alexmuraru27/GameConsole/docu/clock.png

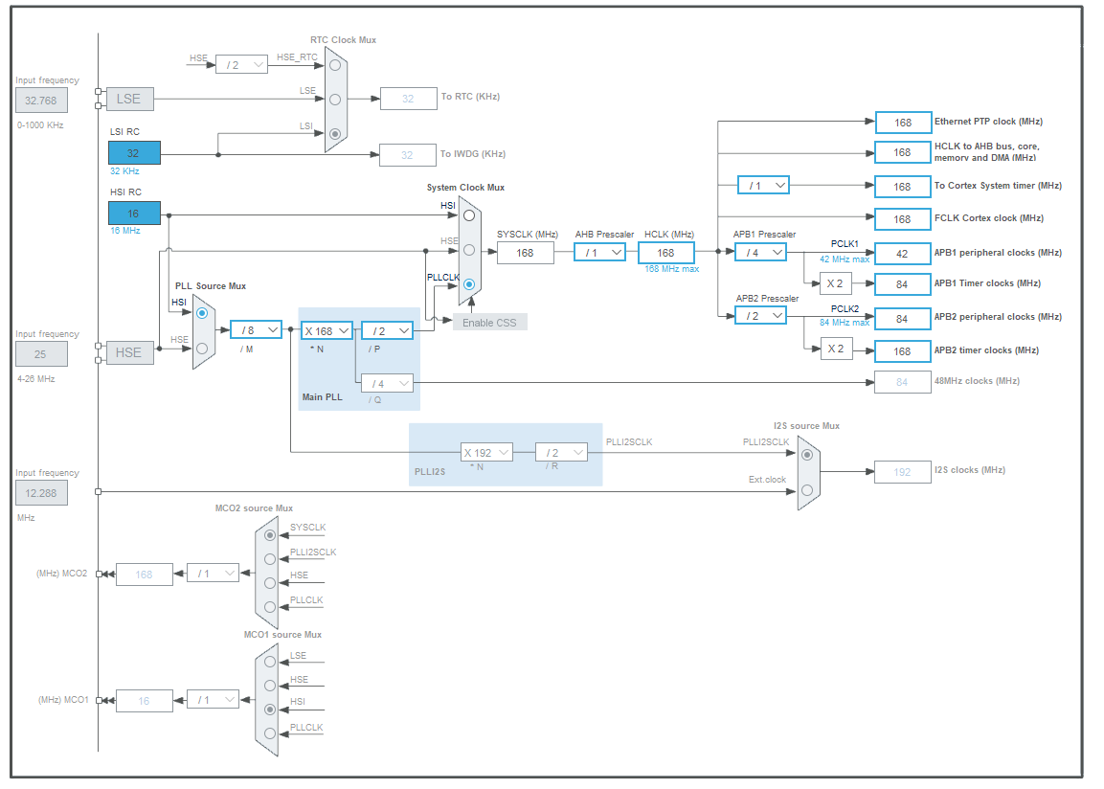
docu/clock.png
