alexmuraru27/GameConsole/docu/tile_creator_docu.png

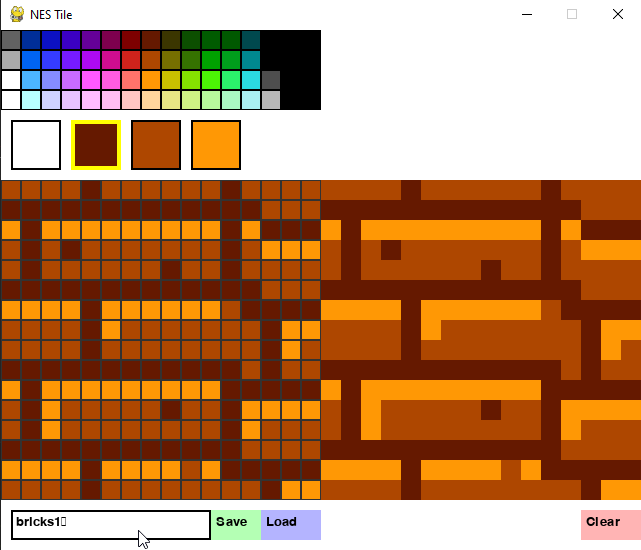
docu/tile_creator_docu.png
