alexmuraru27/GameConsole/docu/HW/BOM_Initial Layout_PCB1_2026-05-29.xlsx

No. | Quantity | Comment | Designator | Footprint | Value | Manufacturer Part | Manufacturer | Supplier Part | Supplier | Primary Category | Secondary Category | Pin Count | LCSC Stock | LCSC Price | JLCPCB Stock | JLCPCB Price | Layer | Mounting Style | Convert to PCB | Add into BOM | 3D Model Title | Device | Name | Unique ID
1 | 2 | YK16S-L7.2-B10Ka(32-8)-G-A29 | AnalogJoyL,AnalogJoyR | JOYTICK-TH_YF16S-FL7.2-B5KB-45-10-Y_1 |  | YK16S-L7.2-B10Ka(32-8)-G-A29 | YTL(亚特联) | C37323746 | LCSC | Switches | Navigation Switches, Joystick | 14 |  |  | 827 | 0.0674 | T | DIP |  | yes | JOYTICK-TH_YF16S-FL7.2-B5KB-45-10-Y_1 | YK16S-L7.2-B10Ka(32-8)-G-A29 | YK16S-L7.2-B10Ka(32-8)-G-A29 | gge6,gge30
2 | 1 | X6511WR-02H-C60D30R2 | BATCON | HDR-TH_2P-P2.54-H-M-W9.7-N |  | X6511WR-02H-C60D30R2 | XKB Connection(中国星坤) | C2883679 | LCSC | Connectors | Pin Headers | 2 |  |  | 74 | 0.0071 | T | DIP |  | yes | HDR-TH_2P-P2.54-H-M-W9.7-N | X6511WR-02H-C60D30R2 | X6511WR-02H-C60D30R2 | gge84
3 | 1 | 2.7kHz | BUZZER1 | BUZ-SMD_4P-L8.5-W8.5-P8.50-BR | 2.7kHz | MLT-8530 | 华能 | C94599 | LCSC | Audio Products / Vibration Motors | Buzzers | 4 |  |  | 86386 | 0.0306 | T | SMT |  | yes | BUZ-SMD_4P-L8.5-W8.5-H3.0 | MLT-8530 | 2.7kHz | gge69
4 | 1 | PM254-2-04-S-8.5 | CN1 | HDR-SMD_8P-P2.54-V-F-R2-C4-S7.1 |  | PM254-2-04-S-8.5 | HCTL(华灿天禄) | C3975149 | LCSC | Connectors | Female Headers | 8 |  |  | 10441 | 0.0268 | T | SMT |  | yes | HDR-SMD_8P-P2.54-V-F-R2-C4-S7.1 | PM254-2-04-S-8.5 | PM254-2-04-S-8.5 | gge73
5 | 1 | X9555WR-2x10-6TV01 | CN2 | CONN-TH_20P-P2.54_XKB_X9555WR-2X10-6TV01 |  | X9555WR-2x10-6TV01 | XKB Connection(中国星坤) | C2884508 | LCSC | Connectors | Wire To Board Connector | 20 |  |  | 1843 | 0.0416 | T | DIP |  | yes | CONN-TH_20P-P2.54_XKB_X9555WR-2X10-6TV01 | X9555WR-2x10-6TV01 | X9555WR-2x10-6TV01 | gge85
6 | 3 | 100nF | C_BAT,C_JTAG,C_SD_VCC | C0402 | 100nF | CL05B104KB54PNC | SAMSUNG(三星) | C307331 | LCSC | Capacitors | Multilayer Ceramic Capacitors MLCC - SMD/SMT | 2 |  |  | 8421035 | 0.0008 | T | SMT |  | yes | C0402_L1.0-W0.5-H0.5 | CL05B104KB54PNC | 100nF | gge32,gge32_2,gge32_3
7 | 1 | 100nF | C_ESP | C0603 | 100nF | CC0603KRX7R9BB104 | YAGEO(国巨) | C14663 | LCSC | Capacitors | Multilayer Ceramic Capacitors MLCC - SMD/SMT | 2 |  |  | 31271923 | 0.0006 | T | SMT |  | yes | C0603_L1.6-W0.8-H0.8 | CC0603KRX7R9BB104 | 100nF | gge83
8 | 2 | 10uF | C_VCAP_1,C_VCAP_2 | C1206 | 10uF | CL31A106KBHNNNE | SAMSUNG(三星) | C13585 | LCSC | Capacitors | Multilayer Ceramic Capacitors MLCC - SMD/SMT | 2 |  |  | 2125757 | 0.0116 | T | SMT |  | yes | C1206_L3.2-W1.6-H1.3 | CL31A106KBHNNNE | 10uF | gge1,gge2
9 | 2 | 22pF | C_XTAL1,C_XTAL2 | C0805 | 22pF | CL21C220JBANNNC | SAMSUNG(三星) | C1804 | LCSC | Capacitors | Multilayer Ceramic Capacitors MLCC - SMD/SMT | 2 |  |  | 173636 | 0.0018 | T | SMT |  | yes | C0805_L2.0-W1.3-H1.3 | CL21C220JBANNNC | 22pF | gge13,gge14
10 | 1 | PZ254V-11-02P | Debug | HDR-TH_2P-P2.54-V-M |  | PZ254V-11-02P | XFCN(兴飞) | C492401 | LCSC | Connectors | Pin Headers | 2 |  |  | 1067702 | 0.0024 | T | DIP |  | yes | HDR2.54-M-LI-1X2P | PZ254V-11-02P | PZ254V-11-02P | gge86
11 | 1 | AT24C512C | EEPROM | SOIC-8_L4.9-W3.9-P1.27-LS6.0-BL |  | AT24C512C | MICROCHIP(美国微芯) | C12371 | LCSC | Memory | EEPROM | 8 |  |  | 39460 | 0.0819 | T | SMT |  | yes | SOIC-8_L4.9-W3.9-H1.7-LS6.0-P1.27 | AT24C512C-SSHD-T | AT24C512C | gge82
12 | 1 | FH-00357 | H2 | CONN-SMD_FH-00357 |  | FH-00357 | Liansheng(连盛) | C2685114 | LCSC | Connectors | Female Headers | 34 |  |  | 1083 | 0.0895 | T | SMT |  | yes | CONN-SMD_FH-00357 | FH-00357 | FH-00357 | gge79
13 | 1 | TF PUSH | MicroSD | TF-SMD_TF-PUSH |  | TF PUSH | SHOU HAN(首韩) | C393941 | LCSC | Connectors | SD Card / Memory Card Connector | 13 |  |  | 182236 | 0.0097 | T | SMT |  | yes | TF-SMD_TF-PUSH | TF PUSH | TF PUSH | gge5
14 | 1 | AO3400-SOT23-3L | Q_BUZZ | SOT-23-3_L2.9-W1.6-P1.90-LS2.8-BR |  | AO3400-SOT23-3L | PUOLOP(迪浦) | C332102 | LCSC | Transistors/Thyristors | MOSFETs | 3 |  |  | 12378 | 0.0047 | T | SMT |  | yes | SOT-23-3L_L2.9-W1.6-H1.1-LS2.8-P0.95 | AO3400-SOT23-3L | AO3400-SOT23-3L | gge80
15 | 17 | 10kΩ | R_BT0,R_BT1,R_BUZZ_PD,R_ESP_1,R_ESP_2,R_ESP_3,R_ESP_4,R_JTAG0,R_JTAG1,R_JTAG2,R_JTAG3,R_JTAG4,R_SD0,R_SD1,R_SD2,R_SD4,R_SD5 | R0603 | 10kΩ | 0603WAF1002T5E | UNI-ROYAL(厚声) | C25804 | LCSC | Resistors | Chip Resistor - Surface Mount | 2 |  |  | 4245882 | 0.0003 | T | SMT |  | yes | R0603 | 0603WAF1002T5E | 10kΩ | gge50,gge50_1,gge50_2,gge50_3,gge51,gge51_1,gge52,gge52_1,gge53,gge53_1,gge54,gge54_1,gge55_1,gge55_2,gge55_3,gge55_5,gge55_6
16 | 1 | 1MΩ | R_XTAL | R1206 | 1MΩ | 1206W4F1004T5E | UNI-ROYAL(厚声) | C17927 | LCSC | Resistors | Chip Resistor - Surface Mount | 2 |  |  | 4682171 | 0.0007 | T | SMT |  | yes | R1206_L3.2-W1.6-H0.6 | 1206W4F1004T5E | 1MΩ | gge12
17 | 1 | STM32F407VET6 | STM32F407VET6 | LQFP-100_L14.0-W14.0-P0.50-LS16.0-BL |  | STM32F407VET6 | ST(意法半导体) | C28730 | LCSC | Embedded Processors & Controllers | Microcontrollers (MCU/MPU/SOC) | 100 |  |  | 29 | 0.5591 | T | SMT |  | yes | LQFP-100_L14.0-W14.0-H1.4-LS16.0-P0.50 | STM32F407VET6 | STM32F407VET6 | gge65
18 | 10 | TS-1003ST-26 | SW_LDPAD_D,SW_LDPAD_L,SW_LDPAD_R,SW_LDPAD_U,SW_RDPAD_D,SW_RDPAD_L,SW_RDPAD_R,SW_RDPAD_U,SW_SDPAD2,SW_SDPAD_1 | SW-SMD_4P-L12.0-W12.0-P5.00-LS15.4 |  | TS-1003ST-26 | XUNPU(讯普) | C455234 | LCSC | Switches | Tactile Switches | 4 |  |  | 5036 | 0.0158 | T | SMT |  | yes | SW-SMD_4P-L12.0-W12.0-H14-P5.00-LS15.2 | TS-1003ST-26 | TS-1003ST-26 | gge71,gge71_1,gge71_2,gge71_3,gge71_4,gge71_5,gge71_6,gge71_7,gge71_8,gge72
19 | 1 | TPS73733DCQR | TPS73733 | SOT-223-6_L6.5-W3.5-P1.27-BL |  | TPS73733DCQR | TI(德州仪器) | C31334 | LCSC | Power Management (PMIC) | Voltage Regulators - Linear, Low Drop Out (LDO) Regulators | 6 |  |  | 14002 | 0.0726 | T | SMT |  | yes | SOT-223-6_L6.5-W3.5-H1.6-LS7.0-P1.27 | TPS73733DCQR | TPS73733DCQR | gge60
20 | 1 | SS12D10G3-WJ | U1 | SW-TH_3P-P4.80_HX-SS12D10G3-WJ |  | SS12D10G3-WJ | SHOU HAN(首韩) | C7431056 | LCSC | Switches | Slide Switches | 3 |  |  | 0 |  | T | DIP |  | yes | SW-TH_3P-P4.80_HX-SS12D10G3-WJ | SS12D10G3-WJ | SS12D10G3-WJ | gge87
21 | 1 | 8MHz | X8MHz | OSC-TH_L10.0-W4.5-P5.00 | 8MHz | X49SD8MSD2SC | YXC(扬兴晶振) | C21263 | LCSC | Crystals, Oscillators, Resonators | Crystals | 2 |  |  | 111687 | 0.013 | T | DIP |  | yes | HC-49US_L11.0-W4.5-H3.5-P4.88 | X49SD8MSD2SC | 8MHz | gge42
