alexmuraru27/GameConsole/docu/HW/Console_Schematic.pdf

# MK-12C02-G025 R_JTAG²

### 10kR_JTAG⁰

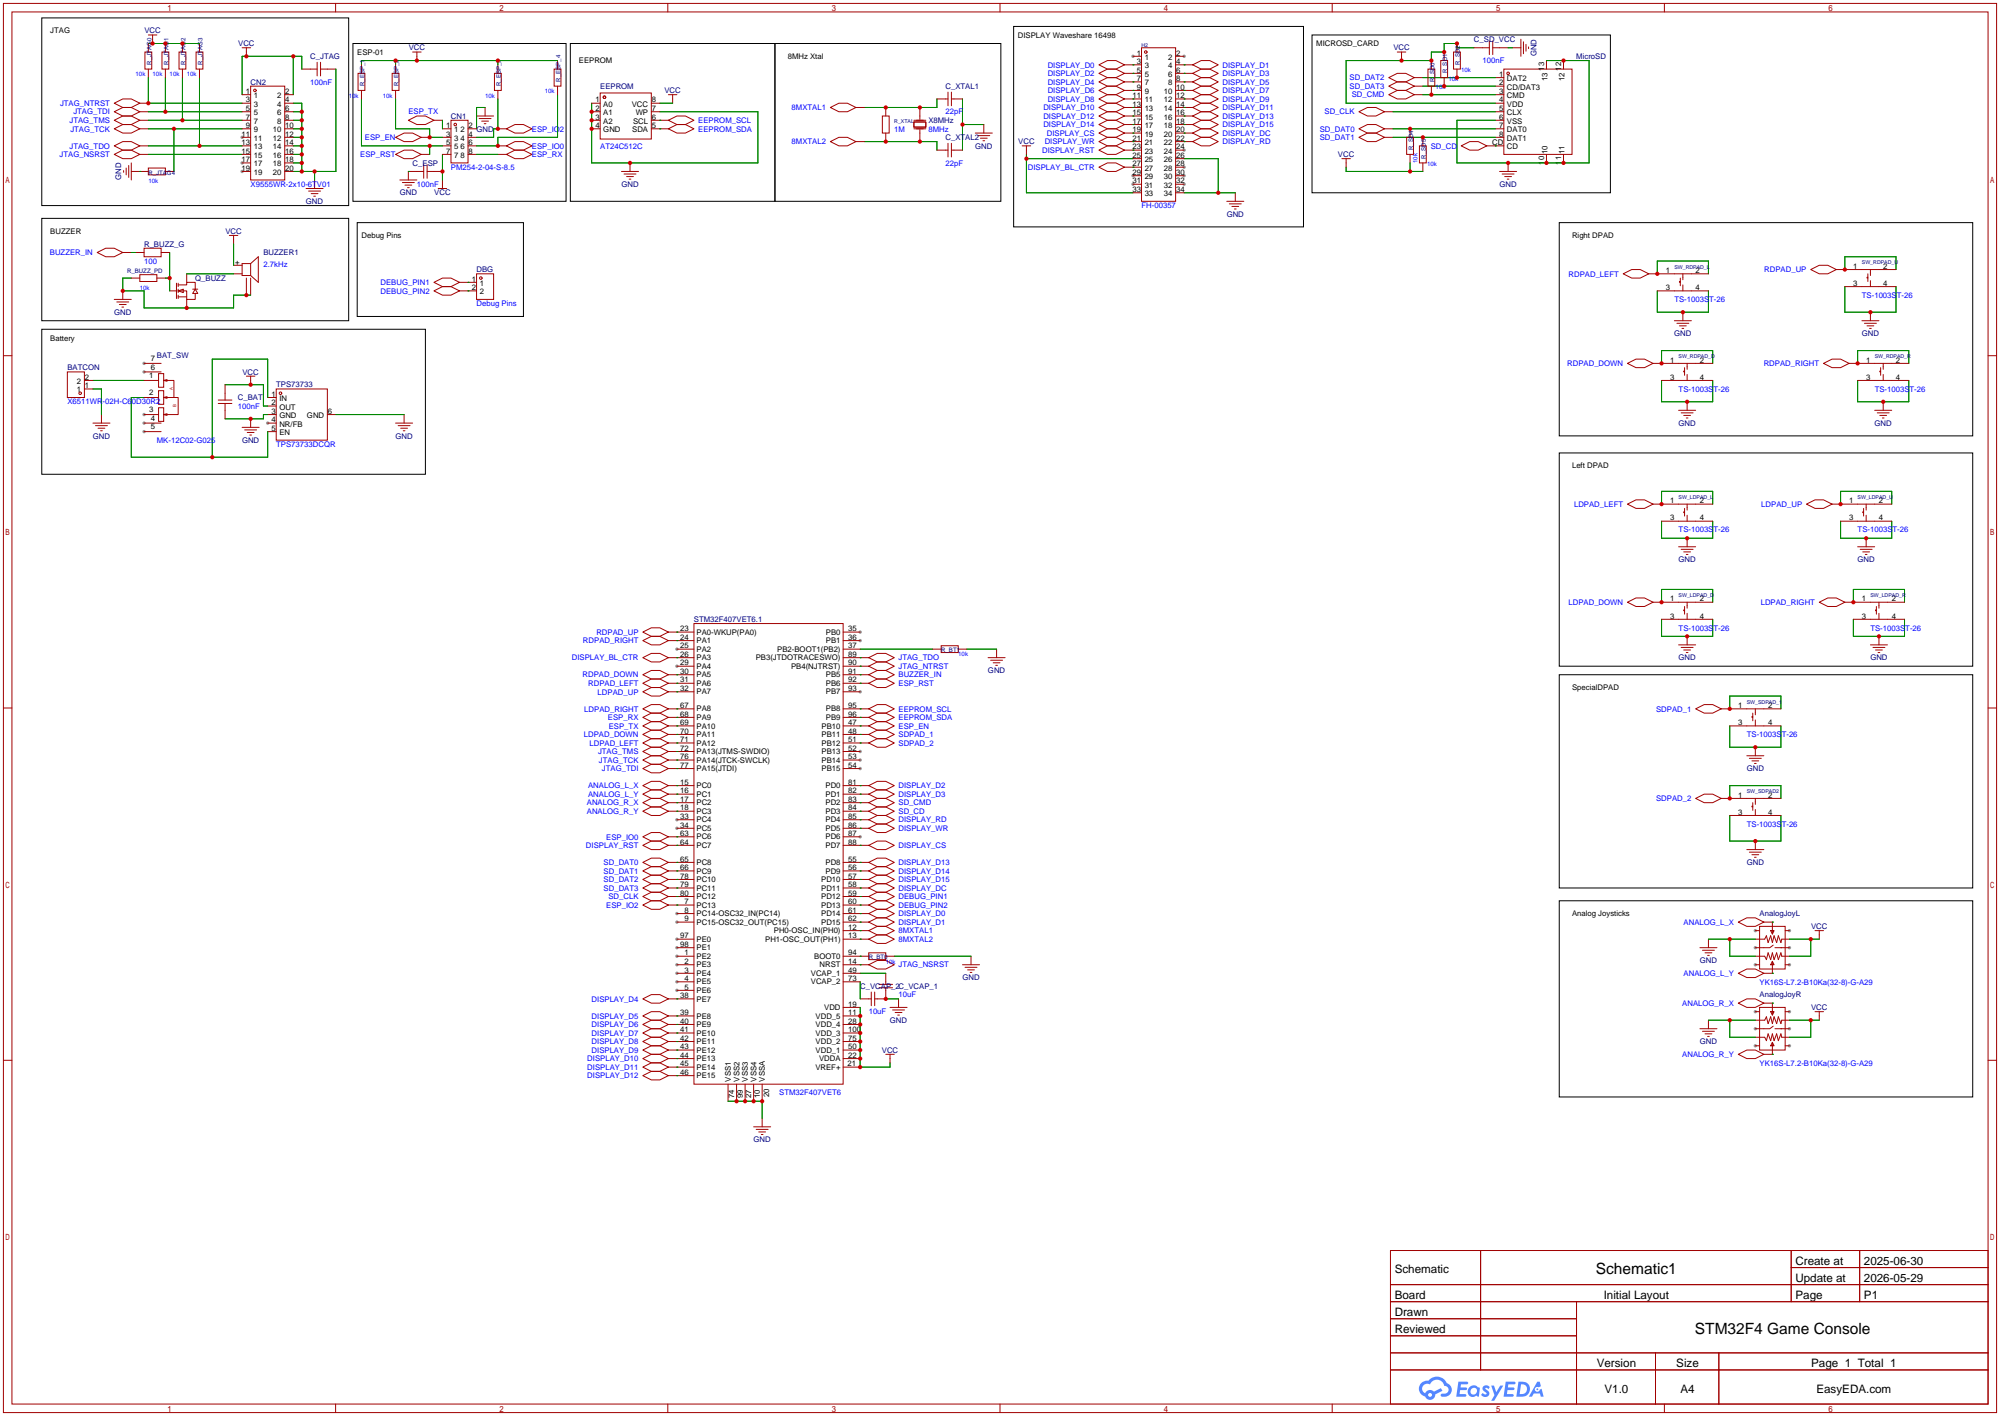
[picture p7: page 1]

Schematic | Schematic1 | Create at | 2025-06-30

Update at | 2026-05-29

Board | Initial Layout | Page | P1
Drawn | | STM32F4 Game Console
Reviewed

Version | Size | Page 1 Total 1
V1.0 | A4 | EasyEDA.com
