alexmuraru27/GameConsole/Console/Src/Devices/external_eeprom.c

#include "Devices/external_eeprom.h"
#include "Peripherals/i2c.h"
#include "Peripherals/sysclock.h"
#include "Peripherals/systime.h"
#include <stddef.h>
#include "Logger/logger.h"

static uint32_t s_device_address = 0U;

void externalEepromInit(const uint32_t device_address)
{
    s_device_address = device_address;
    LOGGER_LOG_INFO(LOGGER_EEPROM, "init: device addr 0x%02lX", (unsigned long)device_address);
}

static uint8_t externalEepromWritePage(const uint16_t mem_addr, const uint8_t *const data, const uint16_t length)
{
    if (data == NULL || length == 0U || length > EXTERNAL_EEPROM_AT24C512_PAGE_SIZE)
    {
        return I2C_ERROR;
    }

    I2C_Status_t status;
    status = i2cStart();
    if (status != I2C_OK)
    {
        return status;
    }

    status = i2cSendAddress(s_device_address, I2C_WRITE);
    if (status != I2C_OK)
    {
        i2cStop();
        return status;
    }

    // send eeprom high memory address
    status = i2cWrite((mem_addr >> 8U) & 0xFF);
    if (status != I2C_OK)
    {
        i2cStop();
        return status;
    }

    // send eeprom low memory address
    status = i2cWrite(mem_addr & 0xFF);
    if (status != I2C_OK)
    {
        i2cStop();
        return status;
    }

    // send data (max 64 bytes per page)
    for (uint16_t i = 0U; i < length; i++)
    {
        status = i2cWrite(data[i]);
        if (status != I2C_OK)
        {
            i2cStop();
            return status;
        }
    }

    i2cStop();
    return I2C_OK;
}

uint8_t externalEepromWrite(const uint16_t mem_addr, const uint8_t *const data, const uint16_t length)
{
    // Reject a write that would run past the end of the device. The end address
    // is computed in 32-bit math so the check itself can't overflow a uint16_t.
    if (data == NULL || length == 0U ||
        ((uint32_t)mem_addr + length - 1U) > EXTERNAL_EEPROM_AT24C512_MAX_MEMORY_ADDR)
    {
        LOGGER_LOG_ERROR(LOGGER_EEPROM, "write rejected: addr=0x%04X len=%u data=%p", (unsigned)mem_addr, (unsigned)length, (const void *)data);
        return I2C_ERROR;
    }

    uint16_t bytes_written = 0U;
    uint16_t current_addr = mem_addr;

    while (bytes_written < length)
    {
        // calculate bytes per page
        const uint16_t page_offset = current_addr % EXTERNAL_EEPROM_AT24C512_PAGE_SIZE;
        const uint16_t bytes_remaining_in_page = EXTERNAL_EEPROM_AT24C512_PAGE_SIZE - page_offset;
        const uint16_t bytes_remaining_total = length - bytes_written;
        const uint16_t bytes_to_write = (bytes_remaining_total < bytes_remaining_in_page) ? bytes_remaining_total : bytes_remaining_in_page;

        // write in this page
        uint8_t status = I2C_OK;
        if (bytes_to_write > 0U)
        {
            status = externalEepromWritePage(current_addr,
                                             &data[bytes_written],
                                             bytes_to_write);
        }

        if (status != I2C_OK)
        {
            LOGGER_LOG_ERROR(LOGGER_EEPROM, "write failed @ 0x%04X (%u/%u bytes): i2c=%u", (unsigned)current_addr, (unsigned)bytes_written, (unsigned)length, (unsigned)status);
            return status;
        }

        bytes_written += bytes_to_write;
        current_addr += bytes_to_write;

        // delay as per message catalog Write Cycle Time (tWR): 5ms maximum
        delay(5U);
    }

    LOGGER_LOG_DEBUG(LOGGER_EEPROM, "write ok: %u bytes @ 0x%04X", (unsigned)length, (unsigned)mem_addr);
    return I2C_OK;
}

uint8_t externalEepromRead(const uint16_t mem_addr, uint8_t *const data, const uint16_t length)
{
    if (mem_addr > EXTERNAL_EEPROM_AT24C512_MAX_MEMORY_ADDR)
    {
        LOGGER_LOG_ERROR(LOGGER_EEPROM, "read rejected: addr=0x%04X out of range", (unsigned)mem_addr);
        return I2C_ERROR;
    }

    I2C_Status_t status;
    status = i2cStart();
    if (status != I2C_OK)
    {
        return status;
    }
    // 1st address with write
    status = i2cSendAddress(s_device_address, I2C_WRITE);
    if (status != I2C_OK)
    {
        i2cStop();
        return status;
    }
    // send eeprom high memory address
    status = i2cWrite((mem_addr >> 8) & 0xFF);
    if (status != I2C_OK)
    {
        i2cStop();
        return status;
    }
    // send eeprom low memory address
    status = i2cWrite(mem_addr & 0xFF);
    if (status != I2C_OK)
    {
        i2cStop();
        return status;
    }

    // 2nd start address
    status = i2cStart();
    if (status != I2C_OK)
    {
        return status;
    }

    // send address read
    status = i2cSendAddress(s_device_address, I2C_READ);
    if (status != I2C_OK)
    {
        i2cStop();
        return status;
    }

    // read the actual data
    for (uint16_t i = 0U; i < length; i++)
    {
        if (i == length - 1)
        {
            // last read has no ack
            status = i2cRead(&data[i], false);
            i2cStop();
            if (status != I2C_OK)
            {
                return status;
            }
        }
        else
        {
            // read with ack
            status = i2cRead(&data[i], true);
            if (status != I2C_OK)
            {
                i2cStop();
                return status;
            }
        }
    }
    LOGGER_LOG_DEBUG(LOGGER_EEPROM, "read ok: %u bytes @ 0x%04X", (unsigned)length, (unsigned)mem_addr);
    return I2C_OK;
}

uint8_t externalEepromClearRange(const uint16_t mem_addr, const uint32_t length)
{
    if (((uint32_t)mem_addr + length) > ((uint32_t)EXTERNAL_EEPROM_AT24C512_MAX_MEMORY_ADDR + 1U))
    {
        return I2C_ERROR;
    }

    const uint8_t zero_page[EXTERNAL_EEPROM_AT24C512_PAGE_SIZE] = {0U};
    uint32_t cleared = 0U;

    while (cleared < length)
    {
        const uint32_t remaining = length - cleared;
        const uint16_t chunk = (remaining < EXTERNAL_EEPROM_AT24C512_PAGE_SIZE)
                                   ? (uint16_t)remaining
                                   : EXTERNAL_EEPROM_AT24C512_PAGE_SIZE;

        const uint8_t status = externalEepromWrite((uint16_t)(mem_addr + cleared), zero_page, chunk);
        if (status != I2C_OK)
        {
            return status;
        }

        cleared += chunk;
    }

    return I2C_OK;
}

uint8_t externalEepromClear()
{
    return externalEepromClearRange(0U, (uint32_t)EXTERNAL_EEPROM_AT24C512_MAX_MEMORY_ADDR + 1U);
}
