alexmuraru27/GameConsole/Apps/GameXO/Inc/game_assets.h

#ifndef __GAME_ASSETS_H
#define __GAME_ASSETS_H

#include "game_console_api.h"
#include <stdbool.h>

/*
 * Thin helpers over the ConsoleAPI for loading this game's packed assets.
 * Graphics are streamed from GameXO.pak into the CCM asset arena (GAME_RAM_ASSET);
 * sound tracks are streamed and handed to the buzzer. Text is drawn directly by
 * the console via rendererDrawText; only the width helper (for centering) lives
 * here.
 */

/* Reset the CCM asset arena. Call once before loading any graphics. */
void gameAssetsInit(void);

/* Load a packed GfxAsset by id into the CCM arena and fill `sprite_out` to point
 * at it (x/y/z = 0; caller positions it). The RGB565 palette is written into
 * `palette_out` (must hold >= 16 entries) and must outlive the sprite. */
bool gameAssetsLoadSprite(uint32_t asset_id, Sprite *sprite_out, uint16_t *palette_out);

/* Load a packed music track by id and play it on buzzer track 0 (stopping any
 * current playback). The notes are kept in a persistent buffer for the buzzer. */
bool gameAssetsPlaySound(uint32_t asset_id);

/* Pixel width of `text` in the given console font (for centering). */
uint16_t gameAssetsTextWidth(FontSize size, const char *text);

#endif /* __GAME_ASSETS_H */
