alexmuraru27/GameConsole/(commit log)

2025-04-23 Sysclock use stm32 defines
2025-04-26 PLL System clock bugfixes
    [main.c, sysclock.c]
2025-04-28 Add Usart hex and Dma skeleton
2025-04-28 Add DMA channel comments and add clocks
2025-04-28 Add DMA to USART2 debug interface
2025-05-04 Add joystick getters and timer file
2025-05-04 Fix joystick IDR logic
    [gpio.c, joystick.c, main.c]
2025-05-04 Remove timer file
2025-05-04 Add analog joystick with DMA
2025-05-04 Add back timer file
2025-05-05 Add functional display driver
2025-05-05 Fast SPI + first moving thing
2025-05-05 Add framerate control
2025-05-06 Update joystick via timer
2025-05-10 Fix USART dma transfer corruption
    [dma.c, usart.c, usart.h]
2025-05-10 Fix joystick bitmask shifting
    [joystick.c]
2025-05-15 Main movement fix tile size guard
    [main.c]
2025-05-16 Fix tile creator offset
    [tile_creator.py]
2025-05-16 Fix restoration last 4 pixels
    [tile_creator.py]
2025-05-16 Add save and load keyboard shortcuts
    [tile_creator.py]
2025-05-17 Add flip support to drawTile
    [main.c]
2025-05-27 Tile creator prompt on button click
2025-05-31 Add background tiles flip
    [main.c]
2025-05-31 Renderer dirty calculation fixes
    [main.c]
2025-05-31 Reverting drawTile to merged version
    [main.c]
2025-06-03 Remove DAC - use Timer PWM
2025-06-03 Fix duty cycle truncation
    [timer.c]
2025-06-04 Buzzer cleanup + priority
    [buzzer.c, main.c, timer.c]
2025-06-04 Fix buzzer end without 0 note
    [buzzer.c, main.c]
2025-06-04 Nicer buzzer API + refactor to CCMRAM
    [buzzer.c, main.c]
2025-06-04 Fix api build by using full struct instead of pointer
    [game_console.c, main.c]
2025-06-10 Move buzzer tests to test_buzzer
    [main.c]
2025-06-17 Fix buggy read condition for asset loader
    [game_console.c, main.c]
2025-06-20 Add font assets and fix struct padding
    [game_console.c, main.c]
2025-06-22 Move drivers to Console directory
2025-06-26 Add pinning mapping for I2C Eeprom
2025-06-27 Add i2c eeprom files
2025-06-27 Add i2c and eeprom driver
2025-07-02 Add console schematic
    [BOM_Initial Layout_PCB1_2025-07-02.xlsx, PickAndPlace_PCB1_2025-07-02.xlsx]
2025-07-03 Fix eeprom to write regarding to memory pages
    [external_eeprom.c]
2025-07-03 Fix eeprom clear with page size
    [external_eeprom.c]
2025-08-12 Update readme structure
    [BOM_Initial Layout_PCB1_2025-07-02.xlsx, PickAndPlace_PCB1_2025-07-02.xlsx]
2025-08-12 Update HW files from EDA
    [BOM_Initial Layout_PCB1_2025-07-02.xlsx, BOM_Initial Layout_PCB1_2025-08-12.xlsx, PickAndPlace_PCB1_2025-07-02.xlsx, PickAndPlace_PCB1_2025-08-12.xlsx]
2026-03-25 Remove Serial SPI display
2026-05-29 Update LCD_BL pin mapping in HW.md
2026-05-29 Update Schematic
    [BOM_Initial Layout_PCB1_2025-08-12.xlsx, PickAndPlace_PCB1_2025-08-12.xlsx]
2026-05-29 Add HW files
    [BOM_Initial Layout_PCB1_2026-05-29.xlsx, PickAndPlace_PCB1_2026-05-29.xlsx]
2026-06-06 Add FSMC dma transfer
2026-06-06 Add sd card inserted check
2026-06-10 Unify buzzer buffers and replace callback with flag
    [buzzer.c, game_console.c, joystick.c, main.c]
2026-06-13 Add sdio writing and fix diskio bug
    [sdio.c, sdio.h]
2026-06-13 Create mute function for the buzzer (night development)
    [buzzer.c, main.c]
2026-06-16 Fix screen flicker via ili9341 timing
    [ILI9341.c, dma.c]
2026-06-18 SD Card hot swap
    [game_console.c]
2026-06-18 Extend storage capacity to max of 2kb per unit
2026-06-18 Fix buzzer heating issue
    [gpio.c, timer.c]
2026-06-19 Add update_server
    [versions.csv]
2026-06-19 Wireless module poll data
2026-06-21 Fix wifi channel + add sw reboot
    [game_console.c, game_console.h, main.cpp]
2026-06-21 Network DMA + retry
2026-06-24 Add delta time between frames
2026-06-25 Enable flash cache and wdt
    [versions.csv]
2026-07-05 Add test buzzer and remove timbre
    [buzzer.c, main.c]
2026-07-05 Fix test renderer clipping
    [main.c]
2026-07-05 Create crash decoder and logger
    [sd_layout.h]
